tmk/capsense_qmatrix/kicad_proj/capsense_qmatrix.png

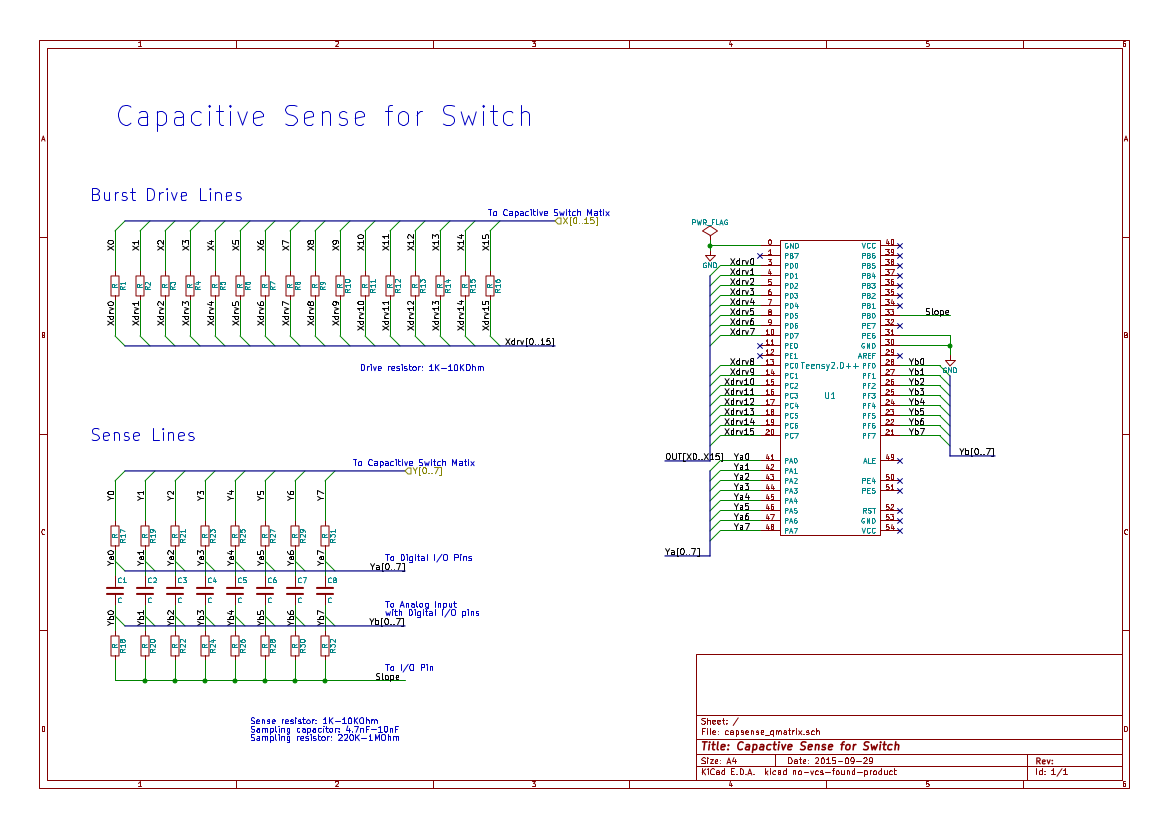
kicad_proj/capsense_qmatrix.png
