tmk/capsense_qmatrix/kicad_proj/capsense_qmatrix.pdf

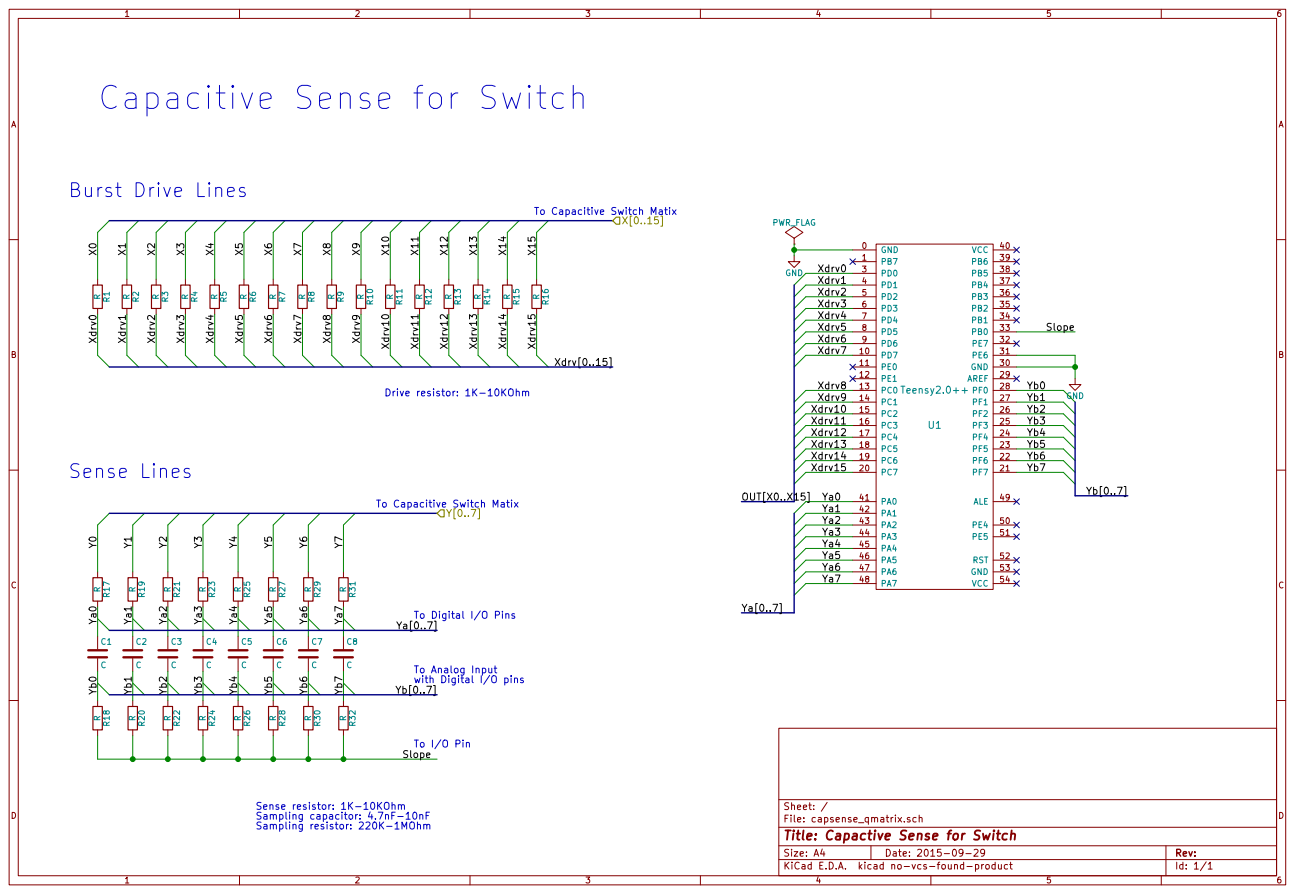
[picture p10: page 1]

Capacitive Sense for Switch

To Capacitive Switch Matix

Id: 1/1 Title: Capactive Sense for Switch
