tmk/capsense_qmatrix/kicad_proj/capsense_qmatrix.sch

## KiCad design kicad_proj/capsense_qmatrix.sch (2015-09-29)

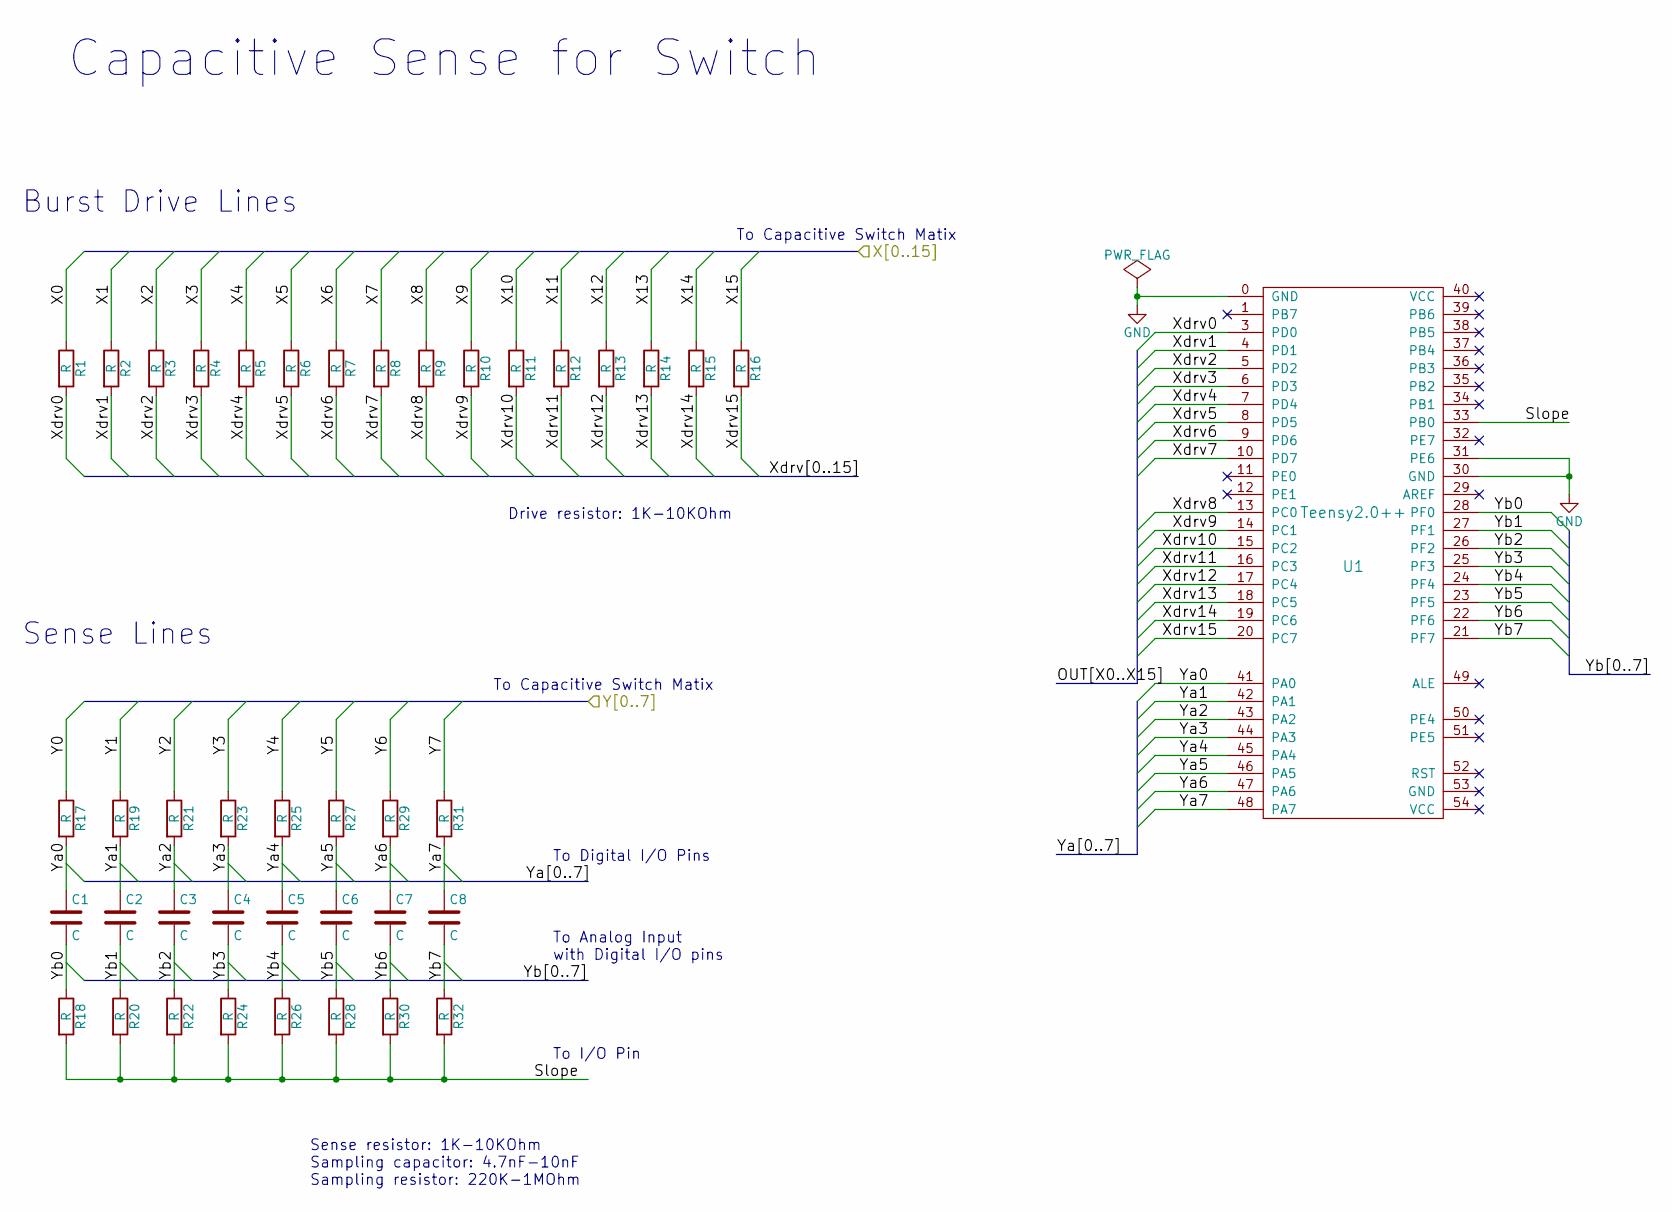
[picture p11: schematic capsense_qmatrix.sch]

Parts:
C1, C2, C3, C4, C5, C6, C7, C8: C
R1, R2, R3, R4, R5, R6, R7, R8, R9, R10, R11, R12, R13, R14, R15, R16, R17, R18, R19, R20, R21, R22, R23, R24, R25, R26, R27, R28, R29, R30, R31, R32: R
U1: Teensy2.0++

Connections:
GND: U1.0 (GND), U1.30 (GND), U1.31 (PE6)
Slope: R18.2, R20.2, R22.2, R24.2, R26.2, R28.2, R30.2, R32.2, U1.33 (PB0)
X0: R1.1
X1: R2.1
X2: R3.1
X3: R4.1
X4: R5.1
X5: R6.1
X6: R7.1
X7: R8.1
X8: R9.1
X9: R10.1
X10: R11.1
X11: R12.1
X12: R13.1
X13: R14.1
X14: R15.1
X15: R16.1
Xdrv0: R1.2, U1.3 (PD0)
Xdrv1: R2.2, U1.4 (PD1)
Xdrv2: R3.2, U1.5 (PD2)
Xdrv3: R4.2, U1.6 (PD3)
Xdrv4: R5.2, U1.7 (PD4)
Xdrv5: R6.2, U1.8 (PD5)
Xdrv6: R7.2, U1.9 (PD6)
Xdrv7: R8.2, U1.10 (PD7)
Xdrv8: R9.2, U1.13 (PC0)
Xdrv9: R10.2, U1.14 (PC1)
Xdrv10: R11.2, U1.15 (PC2)
Xdrv11: R12.2, U1.16 (PC3)
Xdrv12: R13.2, U1.17 (PC4)
Xdrv13: R14.2, U1.18 (PC5)
Xdrv14: R15.2, U1.19 (PC6)
Xdrv15: R16.2, U1.20 (PC7)
Y0: R17.1
Y1: R19.1
Y2: R21.1
Y3: R23.1
Y4: R25.1
Y5: R27.1
Y6: R29.1
Y7: R31.1
Ya0: C1.1, R17.2, U1.41 (PA0)
Ya1: C2.1, R19.2, U1.42 (PA1)
Ya2: C3.1, R21.2, U1.43 (PA2)
Ya3: C4.1, R23.2, U1.44 (PA3)
Ya4: C5.1, R25.2, U1.45 (PA4)
Ya5: C6.1, R27.2, U1.46 (PA5)
Ya6: C7.1, R29.2, U1.47 (PA6)
Ya7: C8.1, R31.2, U1.48 (PA7)
Yb0: C1.2, R18.1, U1.28 (PF0)
Yb1: C2.2, R20.1, U1.27 (PF1)
Yb2: C3.2, R22.1, U1.26 (PF2)
Yb3: C4.2, R24.1, U1.25 (PF3)
Yb4: C5.2, R26.1, U1.24 (PF4)
Yb5: C6.2, R28.1, U1.23 (PF5)
Yb6: C7.2, R30.1, U1.22 (PF6)
Yb7: C8.2, R32.1, U1.21 (PF7)

Notes on the sheet:
Burst Drive Lines
Sense Lines
Sense resistor: 1K-10KOhm Sampling capacitor: 4.7nF-10nF Sampling resistor: 220K-1MOhm
Drive resistor: 1K-10KOhm
Capacitive Sense for Switch
To Digital I/O Pins
To Analog Input with Digital I/O pins
To I/O Pin
To Capacitive Switch Matix
