tmk/capsense_qmatrix/config.h

/*
Copyright 2015 Jun Wako <wakojun@gmail.com>

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
You should have received a copy of the GNU General Public License
along with this program.  If not, see <http://www.gnu.org/licenses/>.
*/

#ifndef CONFIG_H
#define CONFIG_H


#define VENDOR_ID       0xFEED
#define PRODUCT_ID      0x10CC
#define DEVICE_VER      0x0100
#define MANUFACTURER    TMK
#define PRODUCT         Capsense Controller
#define DESCRIPTION     TMK Controller for Topre


/* matrix size */
#define MATRIX_ROWS 16
#define MATRIX_COLS 8

/* key combination for command */
#define IS_COMMAND() ( \
    keyboard_report->mods == (MOD_BIT(KC_LSHIFT) | MOD_BIT(KC_RSHIFT)) \
)


#endif
