tmk/capsense_qmatrix/(commit log)

2015-08-13 Test for Topre capacitive sesing
2015-08-28 add util for debug print
2015-09-08 Change sensing values print
2015-09-18 Add calibrate()
2015-09-24 Squashed 'tmk_core/' content from commit 57d27a8
    git-subtree-dir: tmk_core
    git-subtree-split: 57d27a8e39173a589b4abae74851f95c39940174
    [BoardDeviceMap.cfg, BootloaderDeviceMap.cfg, master.cfg]
2015-09-29 Add kicad project files
    [capsense_qmatrix.sch]
2015-09-29 Move calibrate code to realfoce.c
2015-09-30 Add circuit schematic image
